uhi22/stepup-test/(commit log)

2024-05-05 docu: added basic schematic and fixed file names
2024-05-05 more power, more voltage
2024-05-11 results of the damping
    [calculations.xlsx]
2024-05-22 gate driver, voltage sense board and regulation
    [calculations.xlsx]
2024-05-26 added arduino-wh32eth which controls DAC4725 and receives special homeplug message
2024-05-27 added ADC. correct scaling of AD and DA values. Cleanup.
    [arduino-wt32eth.ino, homeplug.ino]
2024-06-04 docu: added pictures
    [calculations.xlsx]
